dr3san/RVP-TopeltKell/mech/clock_subassem.SLDASM

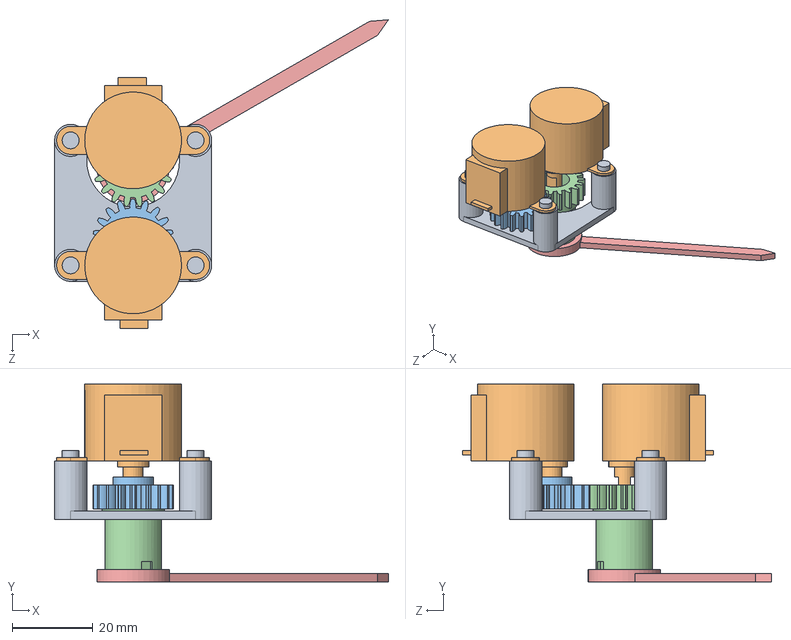
[picture p1: CAD file, 2023-10-10]
mech/clock_subassem.SLDASM
82.8 x 49.0 x 76.5 mm
clock_frame
clock_stepper_28byj-48 x 2
clock_gear_stepper
clock_gear_hour
clock_hand_hour
