dr3san/RVP-TopeltKell/mech/clockface_subassem.SLDASM

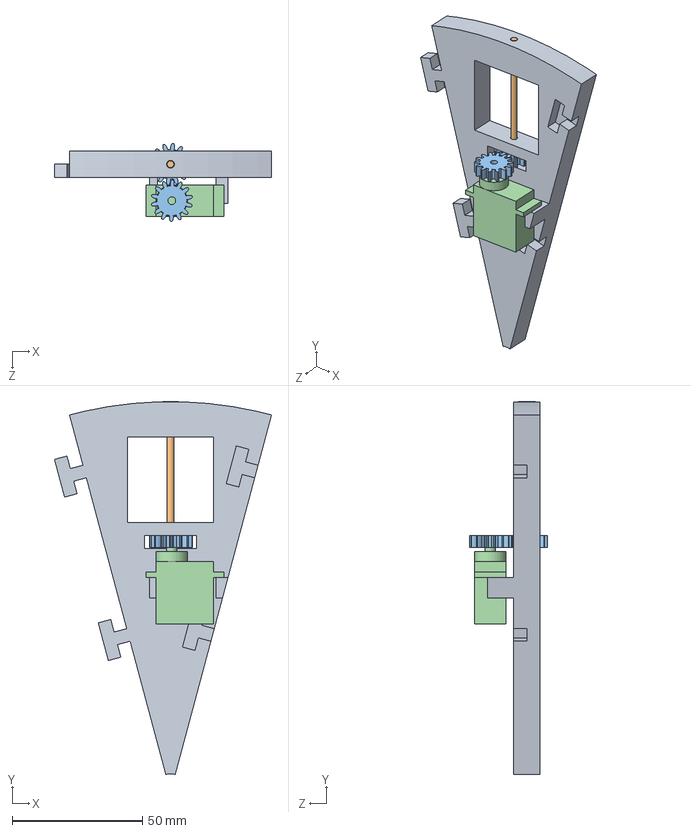
[picture p2: CAD file, 2023-10-10]
mech/clockface_subassem.SLDASM
83.4 x 143.3 x 30.0 mm
sihverplaat_servo
numbriplaat_shaft
spur gear_am x 2
servo
