dr3san/RVP-TopeltKell/mech/clockhand_mount.SLDASM

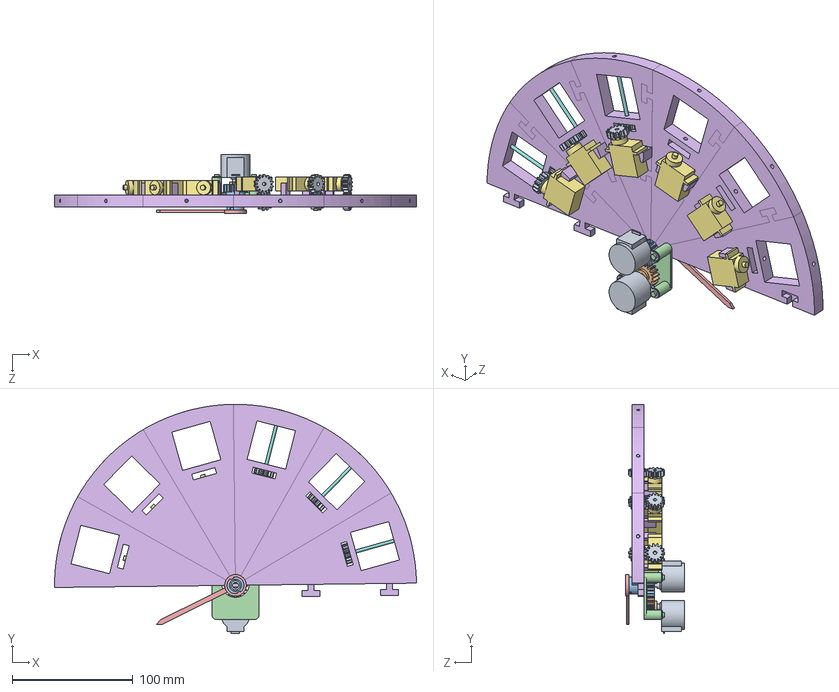
[picture p3: CAD file, 2023-10-10]
mech/clockhand_mount.SLDASM
300.0 x 190.1 x 49.0 mm
stepper_28byj-48 x 2
gear_stepper_fix
gear_hour
stepper_assem_frame
hand_hour
sihverplaat_servo x 6
servo x 6
numbriplaat_shaft x 3
spur gear_am x 6
