dr3san/RVP-TopeltKell/skeem/3Dmodels/ESP32-S3-WROOM-1-N16R2.STEP

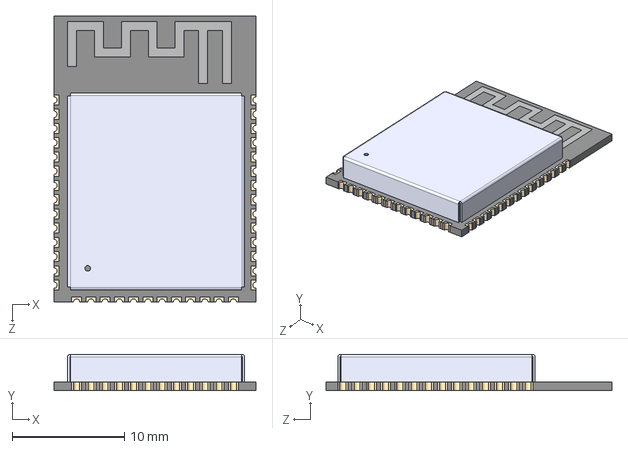
[picture p4: CAD file, 2023-11-13]
skeem/3Dmodels/ESP32-S3-WROOM-1-N16R2.STEP
18.0 x 3.25 x 25.5 mm
