dr3san/RVP-TopeltKell/mech/clock_hand_hour.SLDPRT

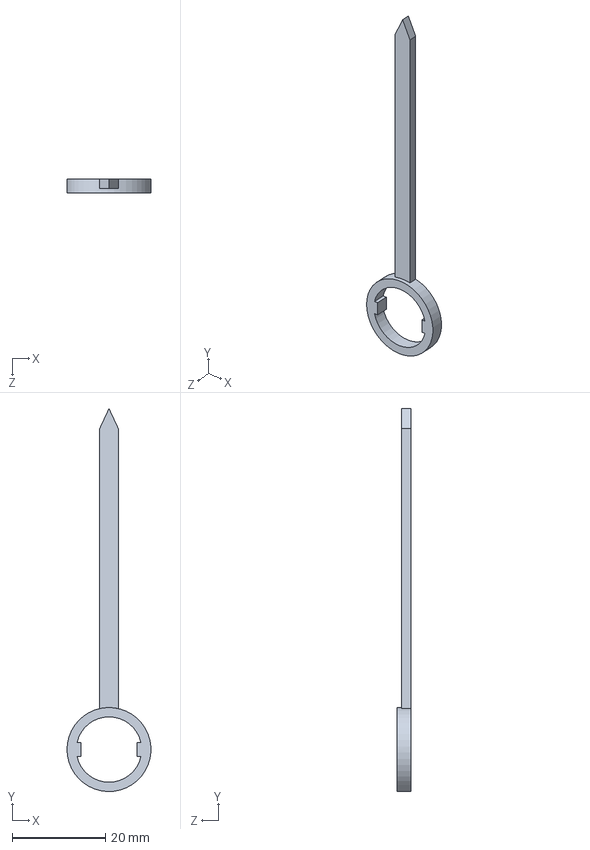
[picture p5: CAD file, 2023-10-10]
mech/clock_hand_hour.SLDPRT
18.0 x 82.1 x 3.00 mm
