dr3san/RVP-TopeltKell/mech/clock_gear_hour.SLDPRT

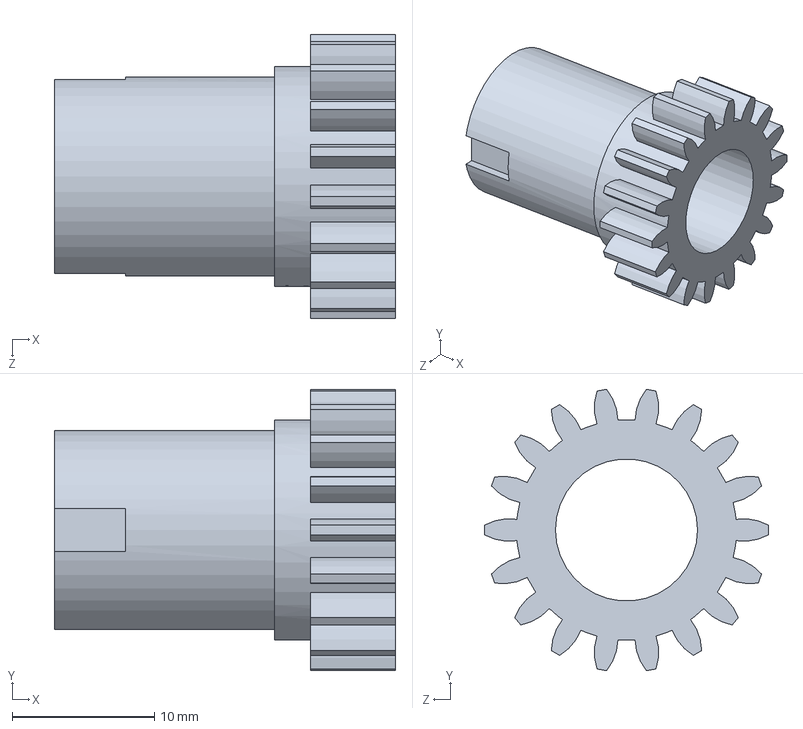
[picture p6: CAD file, 2023-10-10]
mech/clock_gear_hour.SLDPRT
24.0 x 19.8 x 20.0 mm
