dr3san/RVP-TopeltKell/mech/clockface_shaft.SLDPRT

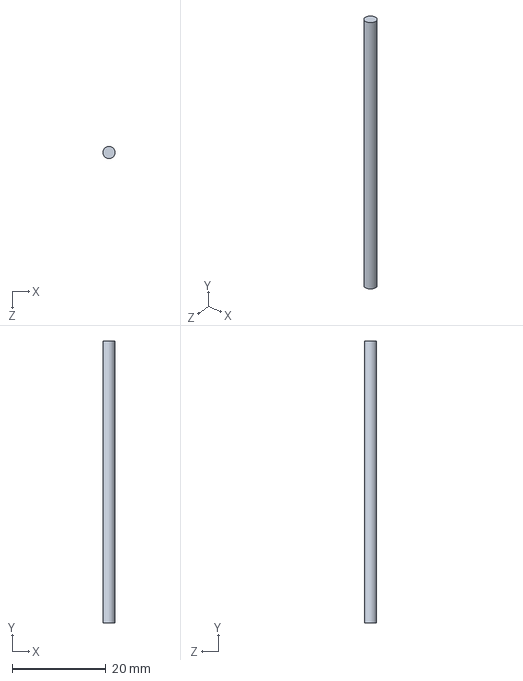
[picture p7: CAD file, 2023-10-10]
mech/clockface_shaft.SLDPRT
2.60 x 60.0 x 2.60 mm
