dr3san/RVP-TopeltKell/mech/clockface_servo.SLDPRT

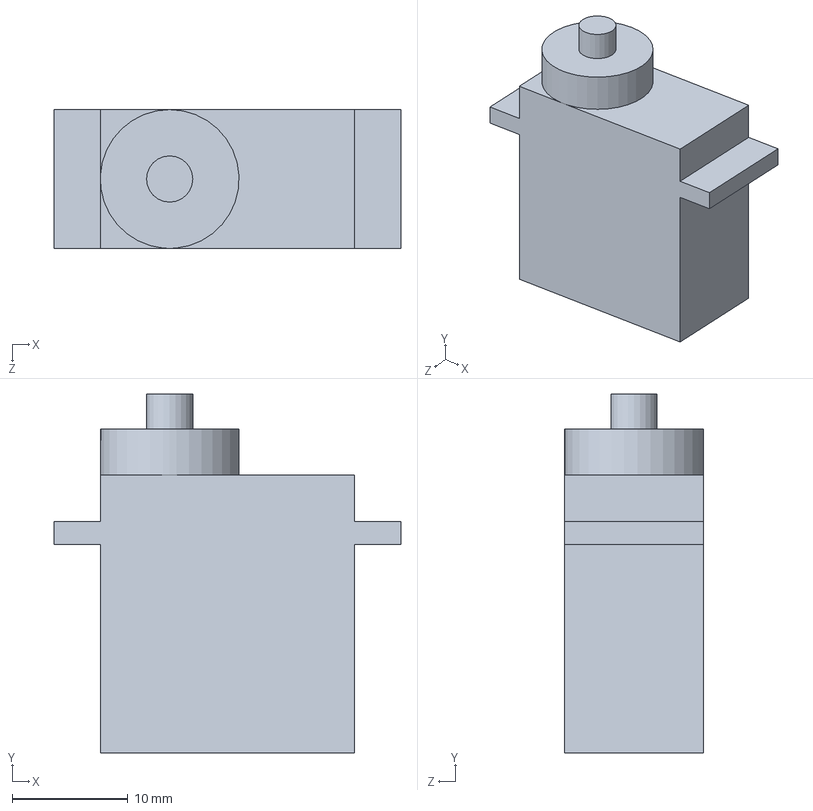
[picture p8: CAD file, 2023-10-10]
mech/clockface_servo.SLDPRT
30.0 x 31.0 x 12.0 mm
