dr3san/RVP-TopeltKell/mech/clockface_gear.SLDPRT

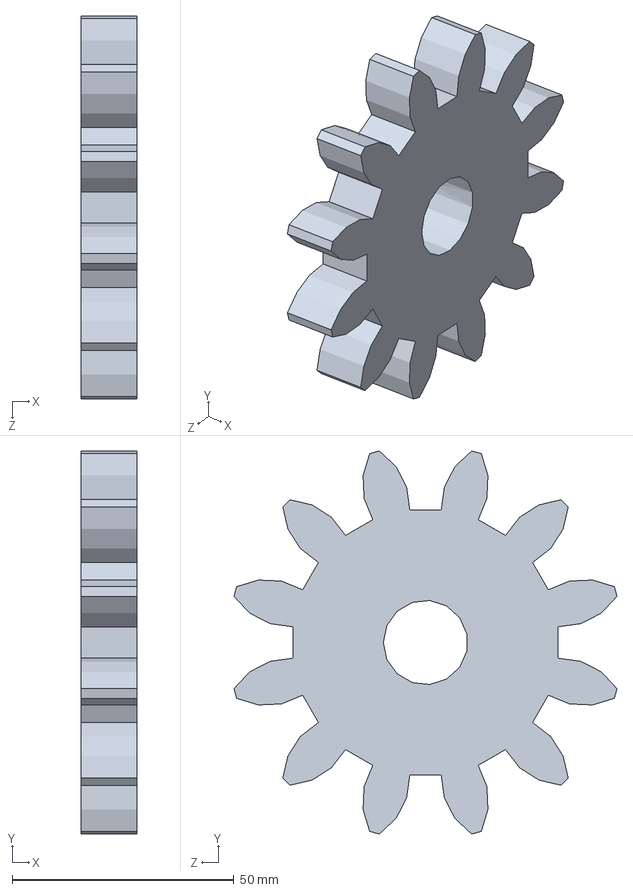
[picture p9: CAD file, 2023-10-10]
mech/clockface_gear.SLDPRT
12.7 x 86.4 x 86.4 mm
