dr3san/RVP-TopeltKell/mech/clock_gear_stepper.SLDPRT

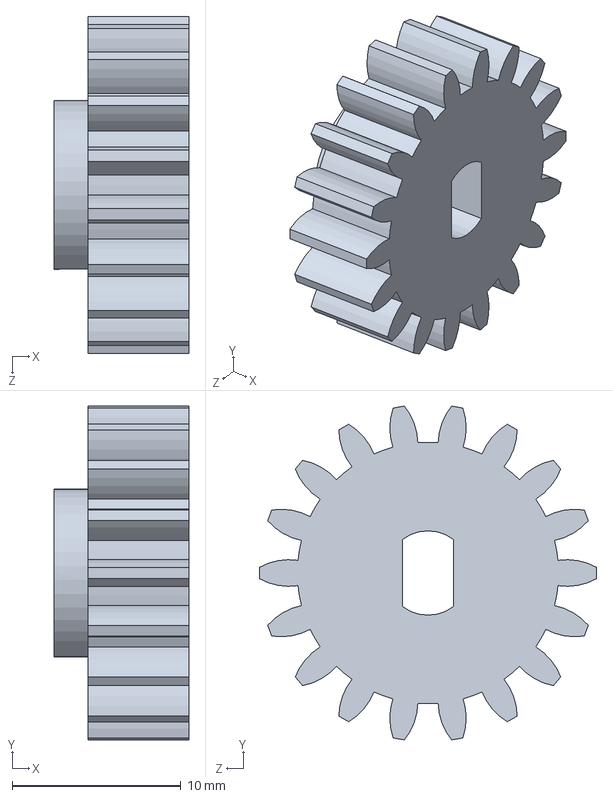
[picture p10: CAD file, 2023-10-10]
mech/clock_gear_stepper.SLDPRT
8.00 x 19.8 x 20.0 mm
