dr3san/RVP-TopeltKell/mech/clock_frame.SLDPRT

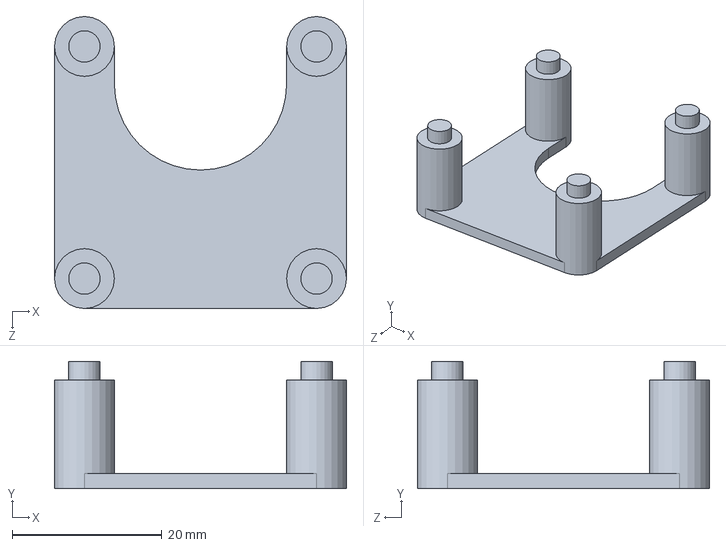
[picture p11: CAD file, 2023-10-10]
mech/clock_frame.SLDPRT
39.0 x 17.0 x 39.0 mm
