dr3san/RVP-TopeltKell/mech/clockface_sector.SLDPRT

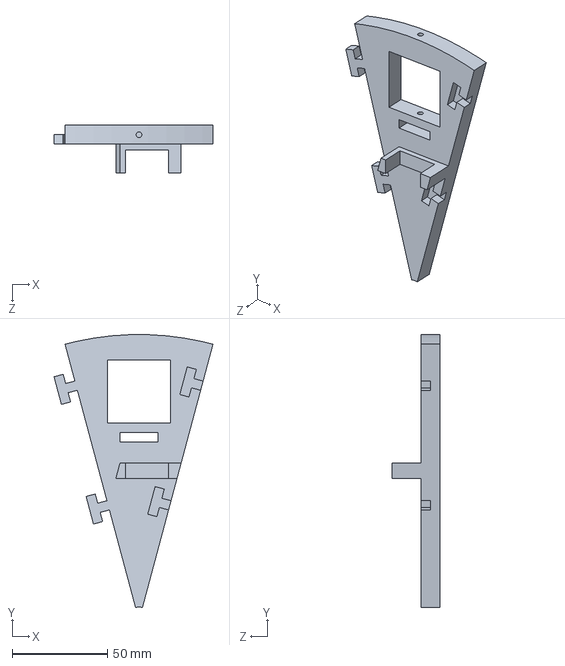
[picture p12: CAD file, 2023-10-10]
mech/clockface_sector.SLDPRT
83.4 x 143.2 x 25.0 mm
