dr3san/RVP-TopeltKell/mech/clock_stepper_28byj-48.SLDPRT

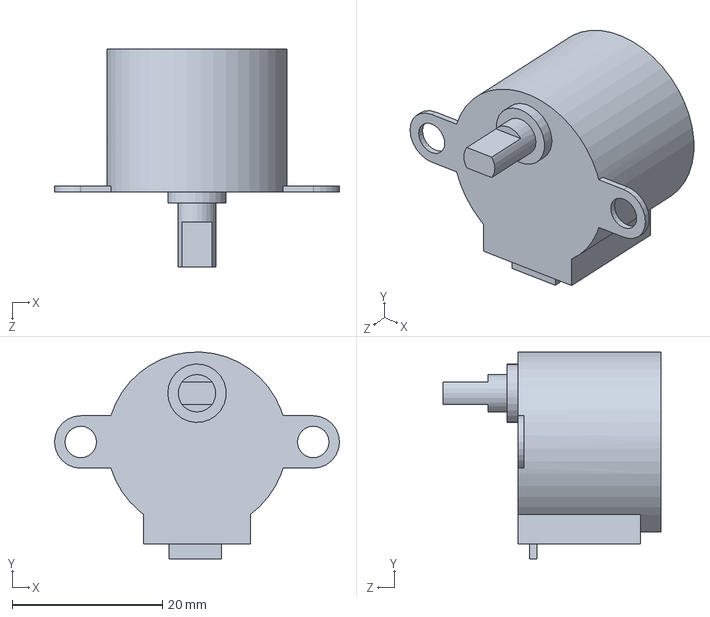
[picture p13: CAD file, 2023-10-10]
mech/clock_stepper_28byj-48.SLDPRT
38.0 x 27.6 x 29.0 mm
