dr3san/RVP-TopeltKell/(list of files, cad)

Other CAD files:
mech/clockface.SLDASM
