dr3san/RVP-TopeltKell/skeem/RVP_TopeltKell.kicad_pcb

## KiCad design skeem/RVP_TopeltKell.kicad_pcb (2023-11-21)

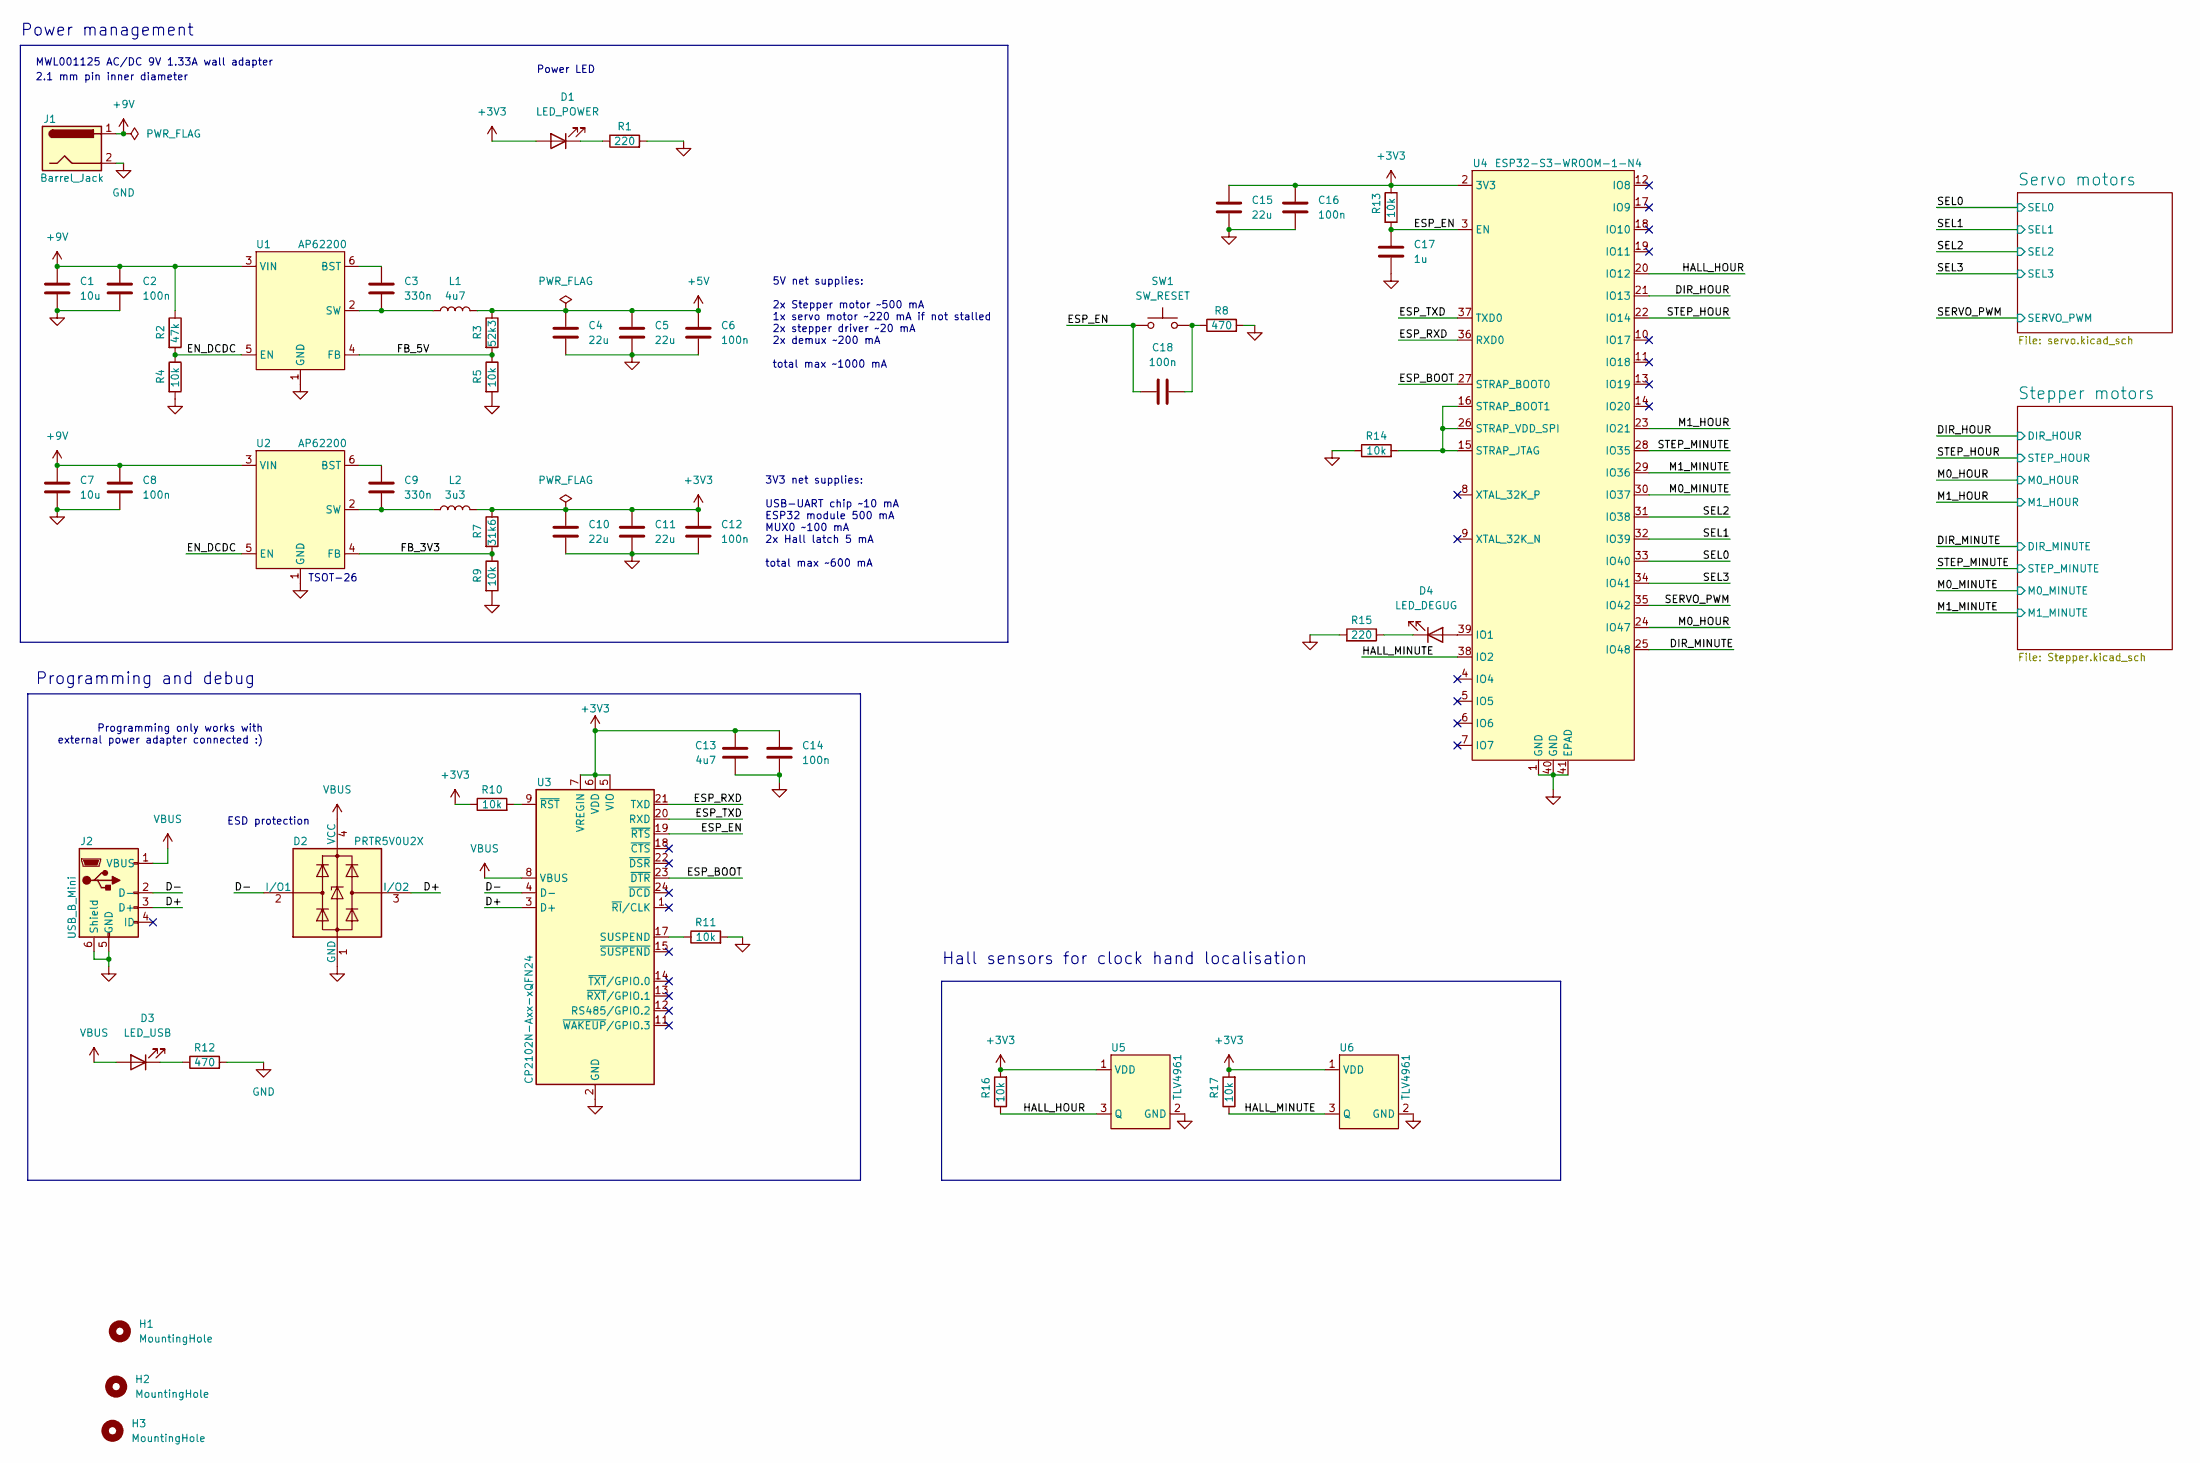
[picture p14: schematic RVP_TopeltKell.kicad_sch, TopeltKell]

Parts:
C1, C7: 10u; C_0805_2012Metric_Pad1.18x1.45mm_HandSolder
C2, C6, C8, C12, C14, C16, C18: 100n; C_0603_1608Metric_Pad1.08x0.95mm_HandSolder
C3, C9: 330n; C_0603_1608Metric_Pad1.08x0.95mm_HandSolder
C4, C5, C10, C11, C15: 22u; C_1206_3216Metric_Pad1.33x1.80mm_HandSolder
C13: 4u7; C_0805_2012Metric_Pad1.18x1.45mm_HandSolder
C17: 1u; C_0805_2012Metric_Pad1.18x1.45mm_HandSolder
D1: LED_POWER; LED_0603_1608Metric_Pad1.05x0.95mm_HandSolder
D2: PRTR5V0U2X; SOT-143
D3: LED_USB; LED_0603_1608Metric_Pad1.05x0.95mm_HandSolder
D4: LED_DEGUG; LED_0603_1608Metric_Pad1.05x0.95mm_HandSolder
H1, H2, H3: MountingHole; MountingHole_3.2mm_M3
J1: Barrel_Jack; BarrelJack_CLIFF_FC681465S_SMT_Horizontal
J2: USB_B_Mini; USB_Mini_B
L1: 4u7; L_Wuerth_WE-PD-Typ-7345
L2: 3u3; L_7.3x7.3_H3.5
R1, R15: 220; R_0603_1608Metric_Pad0.98x0.95mm_HandSolder
R2: 47k; R_0603_1608Metric_Pad0.98x0.95mm_HandSolder
R3: 52k3; R_0603_1608Metric_Pad0.98x0.95mm_HandSolder
R4, R5, R9, R10, R11, R13, R14, R16, R17: 10k; R_0603_1608Metric_Pad0.98x0.95mm_HandSolder
R7: 31k6; R_0603_1608Metric_Pad0.98x0.95mm_HandSolder
R8, R12: 470; R_0603_1608Metric_Pad0.98x0.95mm_HandSolder
SW1: SW_RESET; SW_SPST_EVQQ2
U1, U2: AP62200; TSOT26
U3: CP2102N-Axx-xQFN24; QFN-24-1EP_4x4mm_P0.5mm_EP2.6x2.6mm
U4: ESP32-S3-WROOM-1-N4; ESP32-S3-WROOM-1
U5, U6: TLV4961; TO-92S

Connections:
+5V: C4.1, C5.1, C6.2, L1.2, R3.1; also elsewhere on the board
+9V: C1.1, C2.2, C7.1, C8.2, J1.1, R2.1, U1.3 (VIN), U2.3 (VIN); also elsewhere on the board
/D+: D2.3 (I/O2), J2.3 (D+), U3.3 (D+)
/D-: D2.2 (I/O1), J2.2 (D-), U3.4 (D-)
/DIR_HOUR: U4.21 (IO13); also elsewhere on the board
/DIR_MINUTE: U4.25 (IO48); also elsewhere on the board
/EN_DCDC: R2.2, R4.1, U1.5 (EN), U2.5 (EN)
/ESP_BOOT: U3.23 (~DTR), U4.27 (STRAP_BOOT0)
/ESP_EN: C17.1, C18.2, R13.2, SW1.2, U3.19 (~RTS), U4.3 (EN)
/ESP_RXD: U3.21 (TXD), U4.36 (RXD0)
/ESP_TXD: U3.20 (RXD), U4.37 (TXD0)
/FB_3V3: R7.2, R9.1, U2.4 (FB)
/FB_5V: R3.2, R5.1, U1.4 (FB)
/HALL_HOUR: R16.1, U4.20 (IO12), U5.3 (Q)
/HALL_MINUTE: R17.1, U4.38 (IO2), U6.3 (Q)
/M0_HOUR: U4.24 (IO47); also elsewhere on the board
/M0_MINUTE: U4.30 (IO37); also elsewhere on the board
/M1_HOUR: U4.23 (IO21); also elsewhere on the board
/M1_MINUTE: U4.29 (IO36); also elsewhere on the board
/SEL0: U4.33 (IO40); also elsewhere on the board
/SEL1: U4.32 (IO39); also elsewhere on the board
/SEL2: U4.31 (IO38); also elsewhere on the board
/SEL3: U4.34 (IO41); also elsewhere on the board
/SERVO_PWM: U4.35 (IO42); also elsewhere on the board
/STEP_HOUR: U4.22 (IO14); also elsewhere on the board
/STEP_MINUTE: U4.28 (IO35); also elsewhere on the board
GND: C1.2, C2.1, C4.2, C5.2, C6.1, C7.2, C8.1, C10.2, C11.2, C12.1, C13.1, C14.2, C15.2, C16.2, C17.2, D2.1 (GND), J1.2, J2.5 (GND), J2.6 (Shield), R1.2, R4.2, R5.2, R8.2, R9.2, R11.2, R12.2, R14.1, R15.2, U1.1 (GND), U2.1 (GND), U3.2 (GND), U3.25 (GND), U4.1 (GND), U4.40 (GND), U4.41 (EPAD), U5.2 (GND), U6.2 (GND); also elsewhere on the board
unnamed: C18.1, R8.1, SW1.1
unnamed: D1.1 (K), R1.1
unnamed: D3.1 (K), R12.1
unnamed: D4.2 (A), U4.39 (IO1)
unnamed: D4.1 (K), R15.1
unnamed: C3.2, U1.6 (BST)
unnamed: C3.1, L1.1, U1.2 (SW)
unnamed: C9.2, U2.6 (BST)
unnamed: C9.1, L2.1, U2.2 (SW)
unnamed: R11.1, U3.17 (SUSPEND)
unnamed: R10.2, U3.9 (~RST)
unnamed: R14.2, U4.15 (STRAP_JTAG), U4.16 (STRAP_BOOT1), U4.26 (STRAP_VDD_SPI)
VBUS: D2.4 (VCC), D3.2 (A), J2.1 (VBUS), U3.8 (VBUS)

Notes on the sheet:
ESD protection
Programming only works with external power adapter connected :)
2.1 mm pin inner diameter
MWL001125 AC/DC 9V 1.33A wall adapter
Programming and debug
TSOT-26
3V3 net supplies: USB-UART chip ~10 mA ESP32 module 500 mA MUX0 ~100 mA 2x Hall latch 5 mA total max ~600 mA
5V net supplies: 2x Stepper motor ~500 mA 1x servo motor ~220 mA if not stalled 2x stepper driver ~20 mA 2x demux ~200 mA total max ~1000 mA
Hall sensors for clock hand localisation
Power LED
Power management

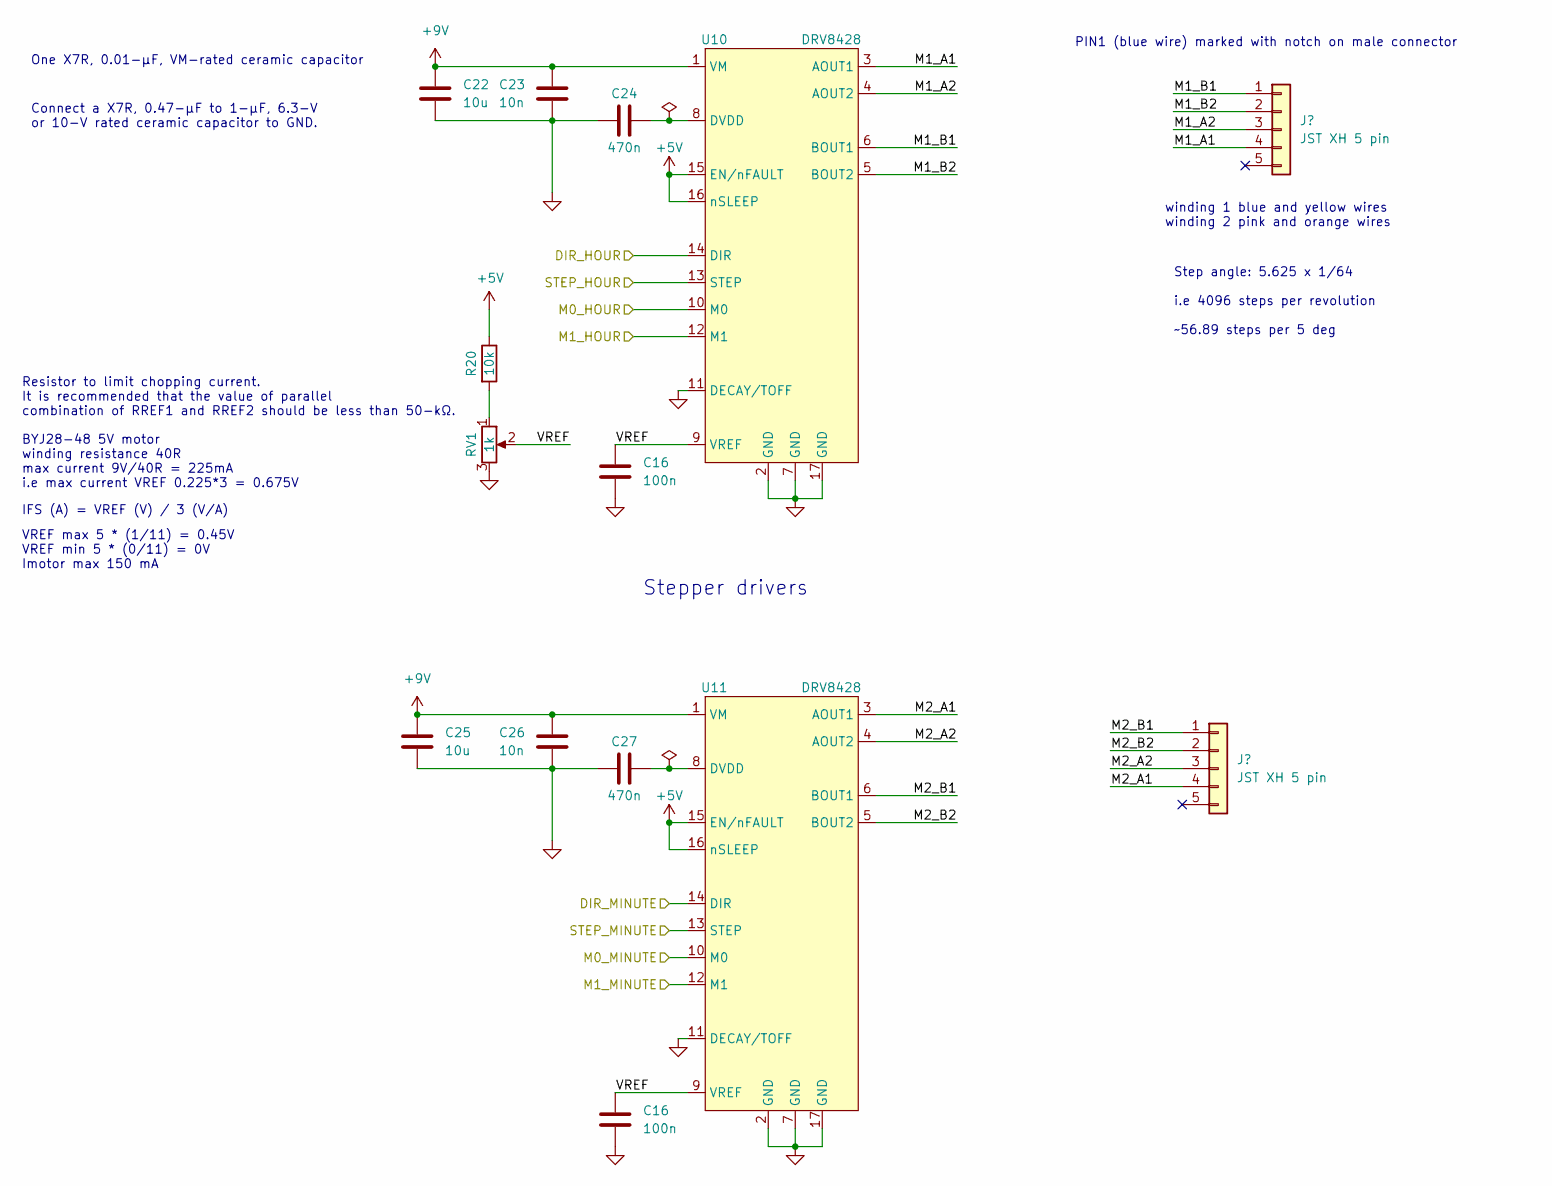
[picture p15: schematic Stepper.kicad_sch]

Parts:
C16: 100n; C_0603_1608Metric_Pad1.08x0.95mm_HandSolder
C22, C25: 10u; C_0805_2012Metric_Pad1.18x1.45mm_HandSolder
C23, C26: 10n; C_0603_1608Metric_Pad1.08x0.95mm_HandSolder
C24, C27: 470n; C_0603_1608Metric_Pad1.08x0.95mm_HandSolder
J15, J16: JST XH 5 pin; JST_XH_B5B-XH-A_1x05_P2.50mm_Vertical
R20: 10k; R_0603_1608Metric_Pad0.98x0.95mm_HandSolder
RV1: 1k; Potentiometer_Bourns_3386P_Vertical
U10, U11: DRV8428; HTSSOP-16-1EP_4.4x5mm_P0.65mm_EP3x3mm

Connections:
+5V: R20.1, U10.15 (EN/nFAULT), U10.16 (nSLEEP), U11.15 (EN/nFAULT), U11.16 (nSLEEP); also elsewhere on the board
+9V: C22.1, C23.2, C25.1, C26.2, U10.1 (VM), U11.1 (VM); also elsewhere on the board
/DIR_HOUR: U10.14 (DIR); also elsewhere on the board
/DIR_MINUTE: U11.14 (DIR); also elsewhere on the board
/M0_HOUR: U10.10 (M0); also elsewhere on the board
/M0_MINUTE: U11.10 (M0); also elsewhere on the board
/M1_HOUR: U10.12 (M1); also elsewhere on the board
/M1_MINUTE: U11.12 (M1); also elsewhere on the board
/STEP_HOUR: U10.13 (STEP); also elsewhere on the board
/STEP_MINUTE: U11.13 (STEP); also elsewhere on the board
/Stepper motors/M1_A1: J15.4, U10.3 (AOUT1)
/Stepper motors/M1_A2: J15.3, U10.4 (AOUT2)
/Stepper motors/M1_B1: J15.1, U10.6 (BOUT1)
/Stepper motors/M1_B2: J15.2, U10.5 (BOUT2)
/Stepper motors/M2_A1: J16.4, U11.3 (AOUT1)
/Stepper motors/M2_A2: J16.3, U11.4 (AOUT2)
/Stepper motors/M2_B1: J16.1, U11.6 (BOUT1)
/Stepper motors/M2_B2: J16.2, U11.5 (BOUT2)
GND: C16.2, C22.2, C23.1, C24.1, C25.2, C26.1, C27.1, RV1.3, U10.2 (GND), U10.7 (GND), U10.11 (DECAY/TOFF), U10.17 (GND), U11.2 (GND), U11.7 (GND), U11.11 (DECAY/TOFF), U11.17 (GND); also elsewhere on the board
unnamed: R20.2, RV1.1
unnamed: C24.2, U10.8 (DVDD)
unnamed: C27.2, U11.8 (DVDD)

Notes on the sheet:
Step angle: 5.625 x 1/64 i.e 4096 steps per revolution ~56.89 steps per 5 deg
Resistor to limit chopping current. It is recommended that the value of parallel combination of RREF1 and RREF2 should be less than 50-kΩ.
Connect a X7R, 0.47-μF to 1-μF, 6.3-V or 10-V rated ceramic capacitor to GND.
VREF max 5 * (1/11) = 0.45V VREF min 5 * (0/11) = 0V Imotor max 150 mA
One X7R, 0.01-μF, VM-rated ceramic capacitor
IFS (A) = VREF (V) / 3 (V/A)
PIN1 (blue wire) marked with notch on male connector
Stepper drivers
BYJ28-48 5V motor winding resistance 40R max current 9V/40R = 225mA i.e max current VREF 0.225*3 = 0.675V
winding 1 blue and yellow wires winding 2 pink and orange wires

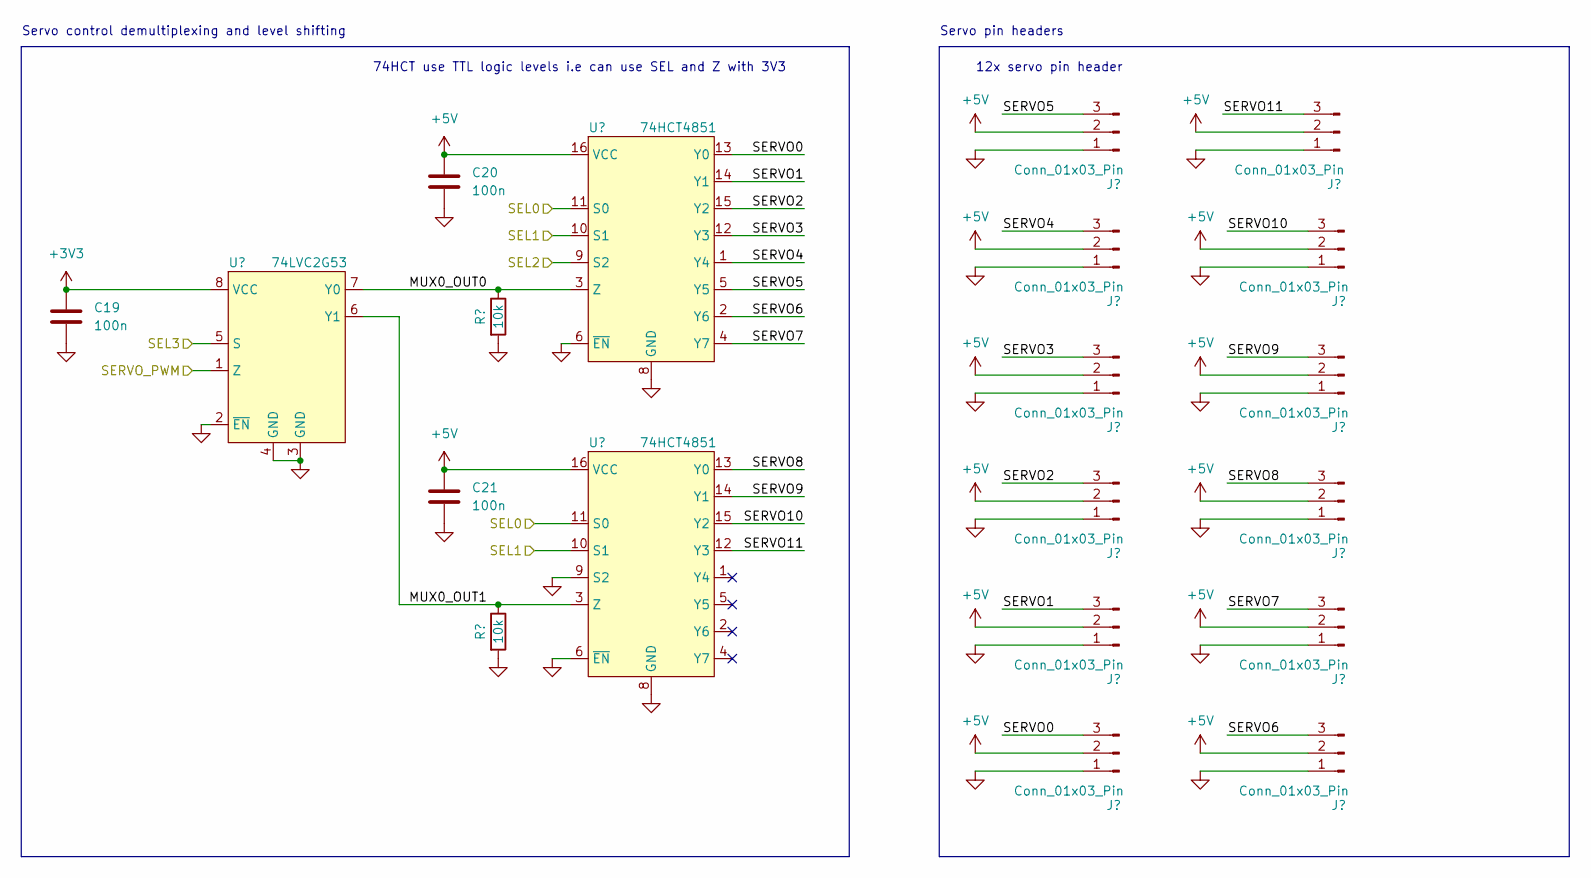
[picture p16: schematic servo.kicad_sch]

Parts:
C19, C20, C21: 100n; C_0603_1608Metric_Pad1.08x0.95mm_HandSolder
J3, J4, J5, J6, J7, J8, J9, J10, J11, J12, J13, J14: Conn_01x03_Pin; PinHeader_1x03_P2.54mm_Vertical
R18, R19: 10k; R_0603_1608Metric_Pad0.98x0.95mm_HandSolder
U7: 74LVC2G53; TSSOP-8_3x3mm_P0.65mm
U8, U9: 74HCT4851; SO-16_3.9x9.9mm_P1.27mm

Connections:
+5V: C20.1, C21.1, J3.2, J4.2, J5.2, J6.2, J7.2, J8.2, J9.2, J10.2, J11.2, J12.2, J13.2, J14.2, U8.16 (VCC), U9.16 (VCC); also elsewhere on the board
/SEL0: U8.11 (S0), U9.11 (S0); also elsewhere on the board
/SEL1: U8.10 (S1), U9.10 (S1); also elsewhere on the board
/SEL2: U8.9 (S2); also elsewhere on the board
/SEL3: U7.5 (S); also elsewhere on the board
/SERVO_PWM: U7.1 (Z); also elsewhere on the board
/Servo motors/MUX0_OUT0: R18.1, U7.7 (Y0), U8.3 (Z)
/Servo motors/MUX0_OUT1: R19.1, U7.6 (Y1), U9.3 (Z)
/Servo motors/SERVO0: J3.3, U8.13 (Y0)
/Servo motors/SERVO1: J4.3, U8.14 (Y1)
/Servo motors/SERVO2: J5.3, U8.15 (Y2)
/Servo motors/SERVO3: J6.3, U8.12 (Y3)
/Servo motors/SERVO4: J7.3, U8.1 (Y4)
/Servo motors/SERVO5: J8.3, U8.5 (Y5)
/Servo motors/SERVO6: J9.3, U8.2 (Y6)
/Servo motors/SERVO7: J10.3, U8.4 (Y7)
/Servo motors/SERVO8: J11.3, U9.13 (Y0)
/Servo motors/SERVO9: J12.3, U9.14 (Y1)
/Servo motors/SERVO10: J13.3, U9.15 (Y2)
/Servo motors/SERVO11: J14.3, U9.12 (Y3)
GND: C19.2, C20.2, C21.2, J3.1, J4.1, J5.1, J6.1, J7.1, J8.1, J9.1, J10.1, J11.1, J12.1, J13.1, J14.1, R18.2, R19.2, U7.2 (~EN), U7.3 (GND), U7.4 (GND), U8.6 (~EN), U8.8 (GND), U9.6 (~EN), U9.8 (GND), U9.9 (S2); also elsewhere on the board

Notes on the sheet:
12x servo pin header
74HCT use TTL logic levels i.e can use SEL and Z with 3V3
Servo pin headers
Servo control demultiplexing and level shifting

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
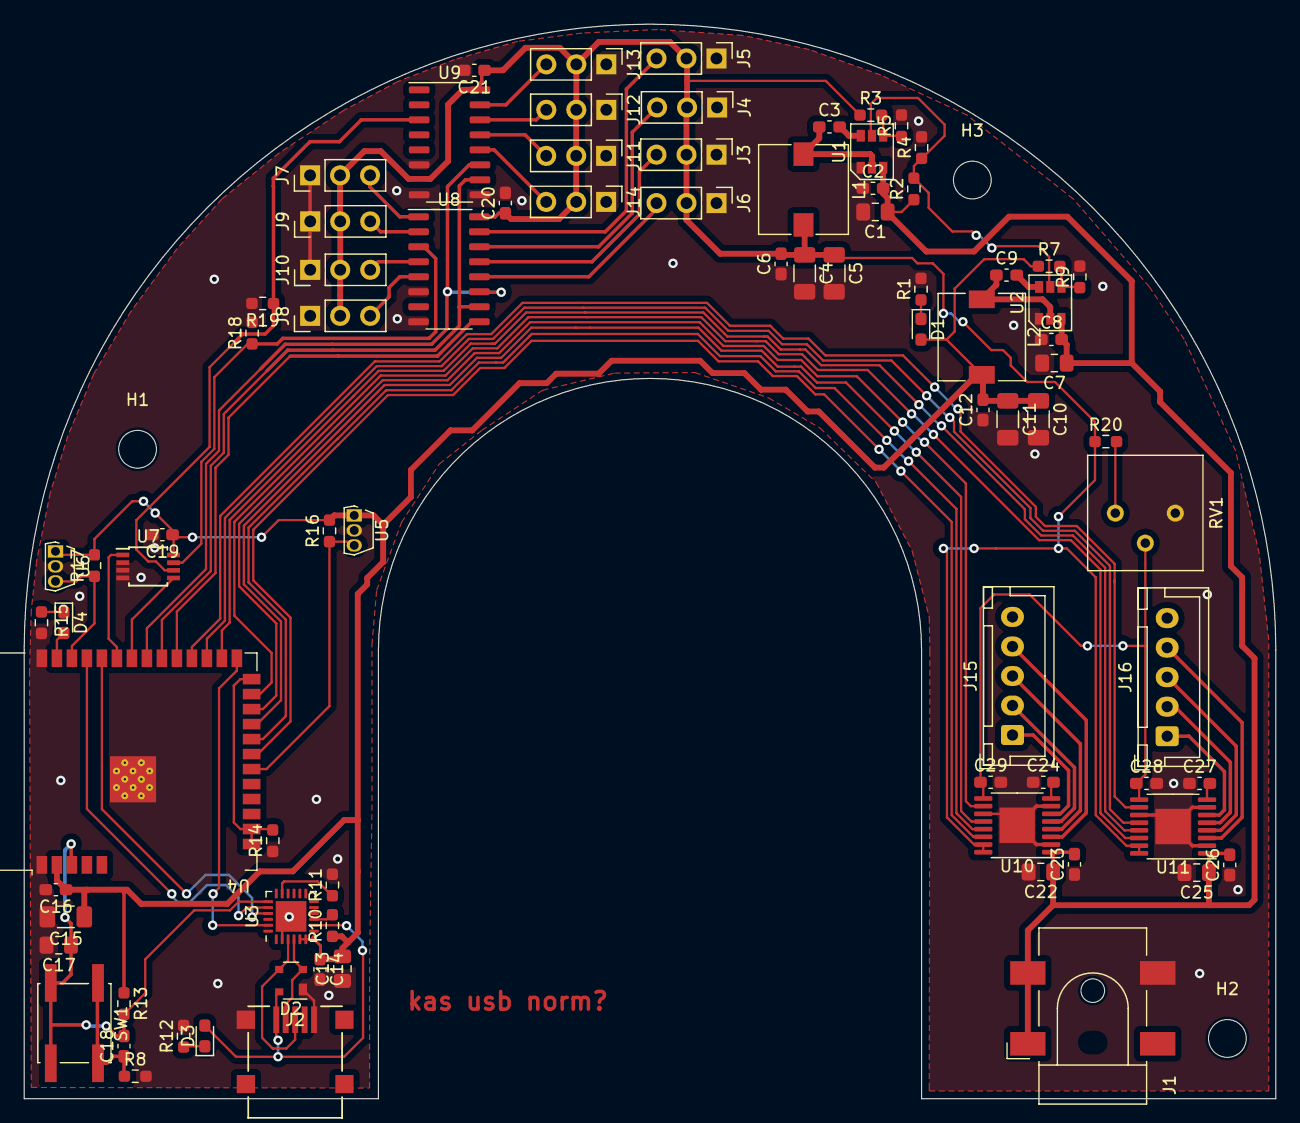
[picture p17: board RVP_TopeltKell.kicad_pcb from above]

Board: 2 copper layers, 106.0 x 91.0 mm, 86 parts (0 on the bottom side), 67 nets.

Other parts of the board:
C28, C29: 100n; C_0603_1608Metric_Pad1.08x0.95mm_HandSolder

Their connections:
GND: C28.2, C29.2; also elsewhere on the board
