dr3san/RVP-TopeltKell/(commit log)

2023-10-14 Lisatud Kicad projekt
    [RVP_TopeltKell.kicad_pcb, RVP_TopeltKell.kicad_sch]
2023-10-18 nibin-nabin skeem
    [RVP_TopeltKell.kicad_sch]
2023-10-20 skeem edeneb
    [RVP_TopeltKell.kicad_sch, Stepper.kicad_sch, servo.kicad_sch]
2023-10-22 Hall Sensor
    [RVP_TopeltKell.kicad_sch, servo.kicad_sch]
2023-10-24 power mgmt
    [RVP_TopeltKell.kicad_sch, Stepper.kicad_sch, servo.kicad_sch]
2023-10-27 nu and impruvd
    [RVP_TopeltKell.kicad_sch, Stepper.kicad_sch, servo.kicad_sch]
2023-10-31 veel skeemi
    [RVP_TopeltKell.kicad_sch, Stepper.kicad_sch, servo.kicad_sch]
2023-11-13 pcb comp placement draft
    [RVP_TopeltKell.kicad_pcb, RVP_TopeltKell.kicad_sch, Stepper.kicad_sch, servo.kicad_sch]
2023-11-13 3d models for pcb
    [ESP32-S3-WROOM-1-N16R2.STEP, RVP_TopeltKell.kicad_pcb]
2023-11-19 natuke pcbd
    [RVP_TopeltKell.kicad_pcb, RVP_TopeltKell.kicad_sch, Stepper.kicad_sch]
2023-11-20 ruuditud v1
    [RVP_TopeltKell.kicad_pcb, RVP_TopeltKell.kicad_sch, Stepper.kicad_sch]
2023-11-21 pisibi valma???
    [RVP_TopeltKell.kicad_pcb, RVP_TopeltKell.kicad_sch]
